captdam/DD-40/design/design spec.md

# ROV Design Spec

## Features
- Control by cable
- Camara FPV

## Physical params
- Displacement:
- Length: 40cm?
- Beam:
- Height:
- Draft:
- Propulsion:
- Speed:
- Range:
- Depth: 40m? (aiming for this goal now, final design may be far? less)

## Electrical param
- Power source: 12V Li-ion battery (or power by cable, or both?)
- Power consumption:
