captdam/DD-40/Communication/README-L1.md

# Communication protocol tech document - Physical layer

## Introduction

In this document, the method used in the physical layer of the communication system will be discussed. Firstly, the design of the circuit will be introduced, and then, the physical implementation will be discussed.

There is full-duplex UART port on the ROV's controller (ATmeage328P) and the operator-side console (STC89C52RC). By connecting the UART port of this two MCUs, the two systems would be able to exchange data between each other directly. Additionally, to give the operator a directly and clearly view of the surrounding environment of the ROV, there is a camera mounted on the ROV, which means there will be an additional wire carrying video signal.

In this document, the following terms will be used:
- Control signal: a digital signal that sends from operator-side console to the ROV. The operator will send this signal to the ROV to control the ROV, or to set up the autopilot function of the ROV.
- Data signal: a digital signal sends from ROV to the operator-side console. The ROV will gather data such as pitch angle, direction etc. and send them to the operator-side console. This signal helps the operator to understand the ROV's statue.
- Video signal: an analog video signal sends from camera of the ROV to the screen on the operator-side console.

Note: The highest frequency that a digital signal could be generated is 0.5 * BAUD (one low bit and one high bit together forms a complete square wave). In this document, the frequency will be calculated by formula "1 * BAUD " instead of "0.5 * BAUD". This will provide a safety factor of 2.

## Design scope

The ROV is a remotely controlled device, such that the deeper the ROV dives, the higher the ROV's capability will be. However, when the depth of the ROV increases, the distance between the ROV and the operator-side console will be increased as well.

Since wireless communication is impossible due to the physical limitation, a cable is applied to connect the ROV and the operator-side console. However, the wire communication still has some issue. The wire acts as an antenna so that it could gather noises. The longer the wire is, the stronger the EMI noise will be gathered from the environment. Additionally, when the transmission speed becomes faster, a stronger noise will be created.

Additionally, the physical layer should provide real-time communication and the circuit delay should be within an acceptable range.

Furthermore, to minimize the cost of the system, the circuit should be as simple as possible.

The physical layer should be able to provide a reliable, real-time (with acceptable delay), and full-duplex transmission.

## Design

### Transmission speed

The higher the transmission speed, the worse the communication quality will be. Therefore, in order to get the best communication quality, the transmission speed should be just higher than the required transmission speed of the application.

According to the testing result from software:
1. The ROV communicates with the operator-side console every 1/4 second.
2. By assuming the ROV and the operator-side console takes about 100ms to prepare data, encode and decode the package, the window for data transmission should be 150ms.
3. In each time, the ROV and the operator exchanges about 20 bytes (10 to 20) of data.
4. Each byte considers as 8 bits with an additional start bit and one additional stop bit.

(8 + 1 + 1) * 20 * (1/0.15) = 1333.33 BAUD

Ceiling to the lowest standard BAUD, the BAUD applies by this system is 2400 BAUD.

### High-voltage differential signalling (RS-485 like)

The MCU on both the operator-side and the ROV comes with a UART port. A typically TTL UART transmission is a single-wire bus to connect a master (drive the wire) with several slaves (High-Z, listen to the wire). When the data is 0, the master will drive the wire low (0V); otherwise, the master will drive the wire high (5V).

However, due to the length of the wire, strong noise could alternate the signal on the wire. When the master drives the wire high, applying a -5V noise could alternate the signal on the wire from 1 to 0; when the master drives the wire low, applying a +5V noise could alternate the signal on the wire from low to high.

TTL UART & Differential signaling

_Source: Wikipedia user upload image (by Linear77, CC BY 3.0)_

To deal with the noise issue, a differential signalling system is applied to the transmission. A differential signalling is a transmission method to send both the original signal and its negative signal. More specifically, when the transmitter sends X (1 or 0), the signal X will be placed on wire A, and the negative X will be placed on wire B. On the receiver side, by comparing the signal on wire A and B, the receiver could know the actual signal comes from the transmitter. Since the environment noise applies to both wires, the difference between the wires will not be alternated. 

For example, when the master drives the wire high, wire A will be high (5V), and wire B will be low (0V). Since the voltage on wire A is higher than the voltage on wire B, the receiver could know the signal on the wire is high:

Tx = 1;

A = 5V; B = 0V;

Rx = (A-B>0) ? 1 : 0 = 1

If applying a XV (X = negative infinity to positive infinity) noise:

Tx = 1;

A' = 5V + X; B' = 0V + X;

A' - B' = (5V + X) - (0V + X) = 5V - 0V = A - B;

By using the differential signalling method, the noise is filtered.

Since the transmission cable and 12V power supply is built in a multi-core cable, the transmission signal could be amplified to 12 V instead of 5V. During this process, the transmission system could handle a stronger EMI noise.

## Circuit design

The differential signalling system circuit is consisted of 3 parts:
- Positive amplifier (Tx+): When it receives logic 1 (5V), the output will be 12V; when it receives logic 0 (0V), the output will be 0V.
- Negative amplifier (Tx-): When it receives logic 1 (5V), the output will be 0V; when it receives logic 0 (0V), the output will be 12V.
- Receiver (Rx): If Rx+ is greater than Rx-, the output will be logic 1 (5V); otherwise, the output will be logic 0 (0V).
Since the transmission system is full duplex, there is a pair of differential signalling transmitter and receiver. One of them is responsible for sending signals from the ROV to the operator-side console, another one is for sending signal from the operator-side console to the ROV.

There are two methods to design this system. One of them is using OpAmp, and the other one is using NMOS. The following circuit and simulation results from LTSpice illustrate that the cable comes with 50 ohms of resistance and 1nC capacitance between the positive-side and negative-side of the wire due to its length.

### Method 1 - OpAmp

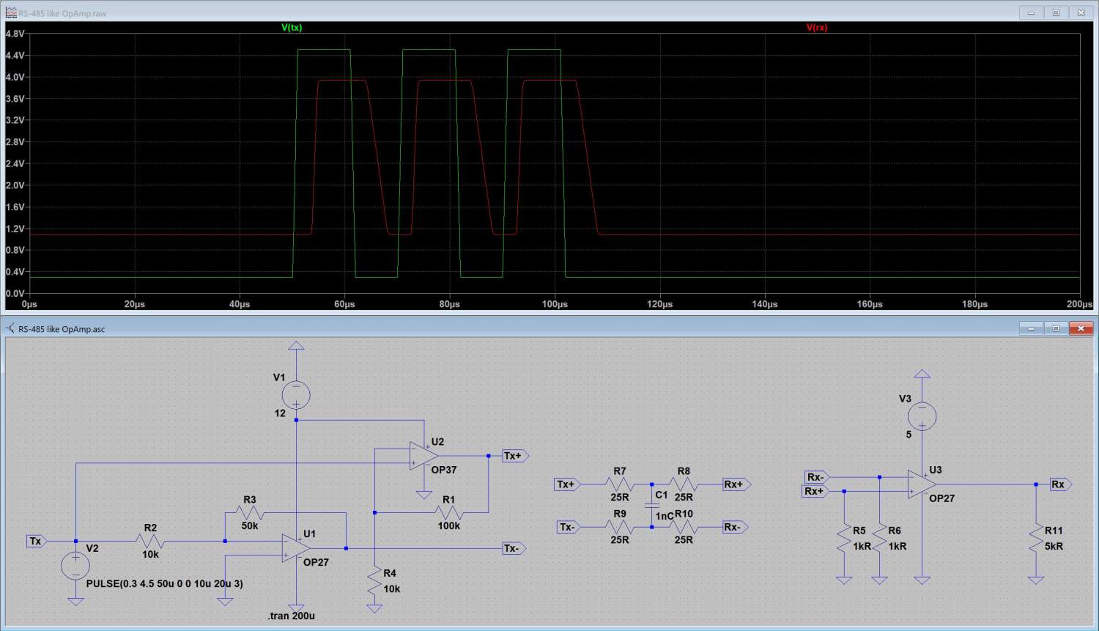
[picture p12: Communication/PhysicalLayer/RS485_like_OpAmp.jpg]
RS-485 using OpAmp


In this circuit, one OP27 is used for the negative amplifier, and one OP37 is used for the positive amplifier on the transmitter side; on the receiver side, another OP27 is used for comparing the voltage on both wires.

According to the simulation result, this solution comes with about 5-microsecond delay.

### Method 2 - NMOS

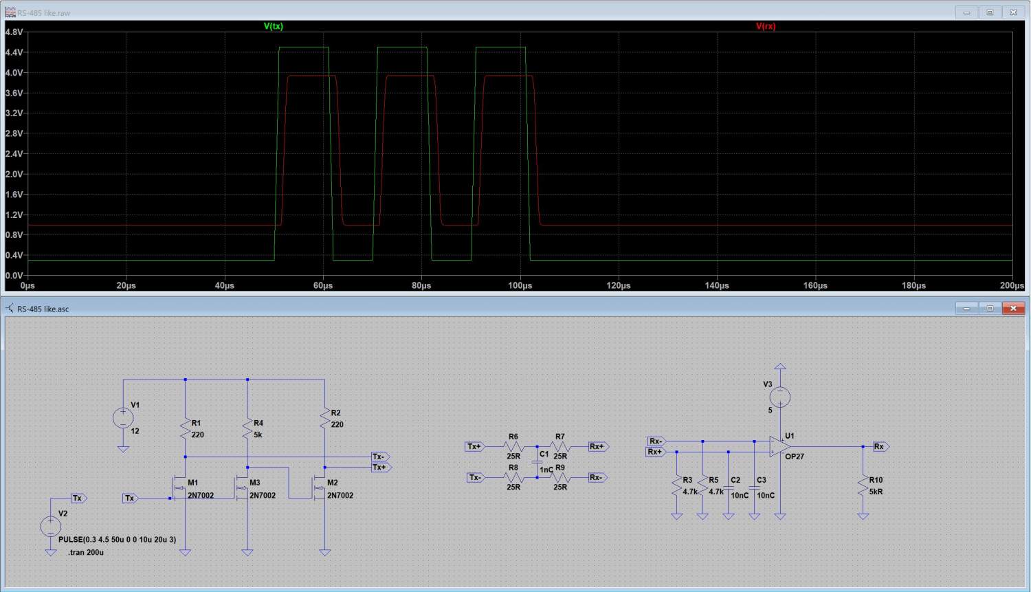
[picture p13: Communication/PhysicalLayer/RS485_like_NMOS.jpg]
RS-485 using NMOS


Like the OpAmp method, this method uses an OP27 as the comparing circuit on the receiver side. However, on the transmitter side, a 2N7002 NMOS is used for a negative amplifier; and two 2N7002 NMOS are cascade to form a positive amplifier.

According to the simulation result, the NMOS method has less delay than the OpAmp method (1.5-microsecond delay) with fewer components. However, there will always be one NMOS turns on, which means higher power consumption. By increasing the value of resistors, the power consumption could be reduced, but circuit delay may increase.

By comparing both methods, the NMOS design is chosen for the communication circuit.

## Circuit implementation

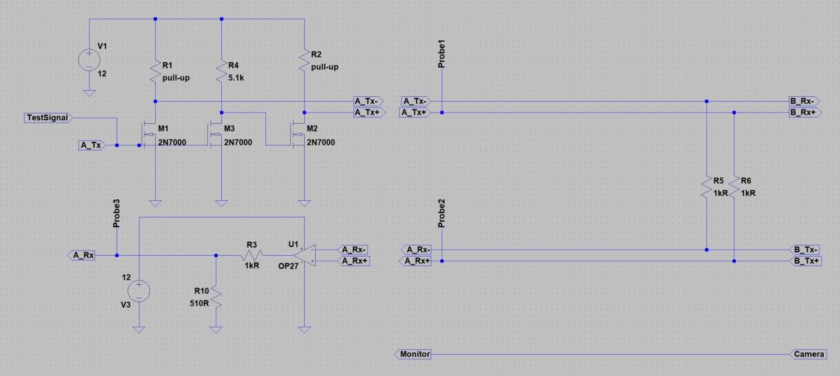
[picture p14: Communication/PhysicalLayer/scheme-test.jpg]
Test scheme


The scheme above is used to test the communication system. To finish the test, a test signal (an adjustable square wave) will be sent to the transmitter. It simulates the operator-side sending control signal to the ROV. The control wire and the data wire are shorted on the ROV side, which simulates the ROV returning the same signal to the operator side. The distance from the operator-side console to the ROV is 10 meters (for one direction).

### Digital signals (control signal and data signal)
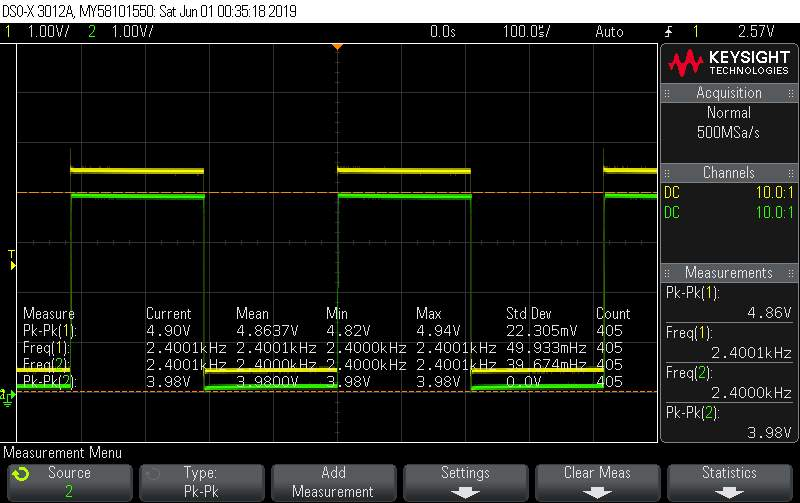
[picture p15: Communication/PhysicalLayer/scope-wave.jpg]
Test wave

 
The graph above shows the typical case. The yellow signal illustrates the input signal on the Tx, and the green signal illustrates the output signal on the Rx.

Because of the inner resistance of the transmitter of the MCU, the test signal is 2.5V+/-2V instead of 2.5V +/2.5V. The purpose of is to ensure the on/off voltage of the actual MCU is compatible with the MOSFET. For example, a TTL MCU may only provide 4.5V when it is logic high. If the Vth (threshold voltage) MOSFET is 4.8V, the 5V test signal will be able to open the MOSFET, but the actual MCU will not.

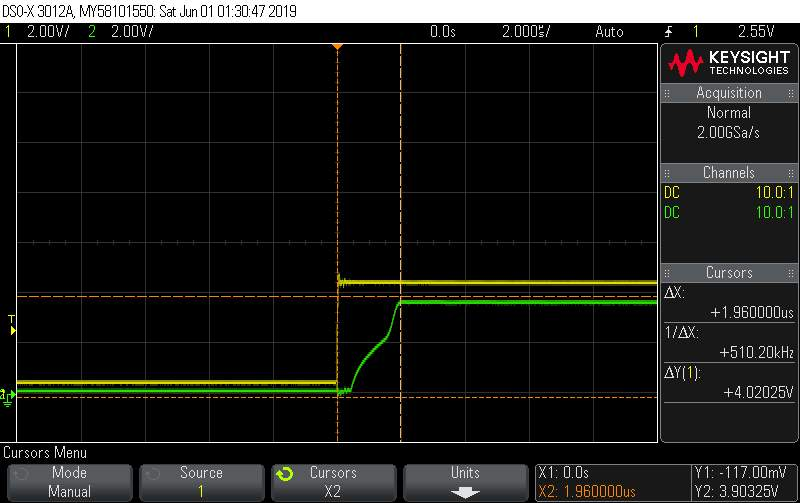
[picture p16: Communication/PhysicalLayer/scope-io.jpg]
Test wave zoom in


In the ideal case, there should be no phase difference between the input and the output signal; however, due to the natural property of the components, there will always be a delay. The communication system should provide a reasonable small delay.

Due to the supply issue, three 2N7000 is used to replace those 2N7002s on the transmitter side; an LM386 is used to replace the OP27 on the receiver side. Furthermore, the actual impedance of the transmission cord is different from the simulation. Therefore, the value of the pull-up resistors needs to be re-selected to have an acceptable compromise between the circuit delay and power consumption.

In fact, finding the suitable values of the resistors by calculation is extremely difficult. Therefore, the "buret-force" method is used to determine the value.

First, assume the pull-up resistor should be 6k ohms:

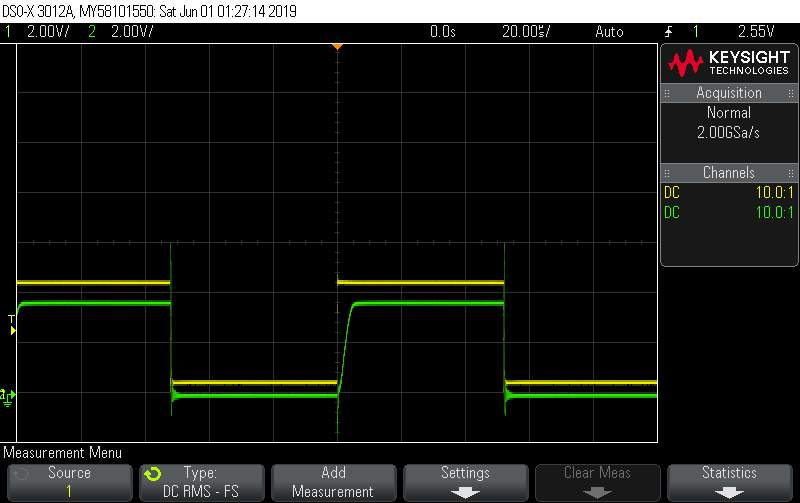
[picture p17: Communication/PhysicalLayer/scope-6k-zo.jpg]


The figure above shows the test signal (yellow) and the wave observed on probe1 (green). It is clear to say that, there is a delay when the signal changing from 0 to 1. This is because the length of wire makes itself to become a capacitor. The pull-up resistor will limit the current flow into the capacitor, which slows down the charging procedure. The result is a slow rising-edge on the wire. For the falling edge, there is no delay, because there is no resistor between the wire and the ground (resistance of MOS is neglectable).

In this case, the delay of the transmitter amplifier on the rising edge takes 5-microseconds:

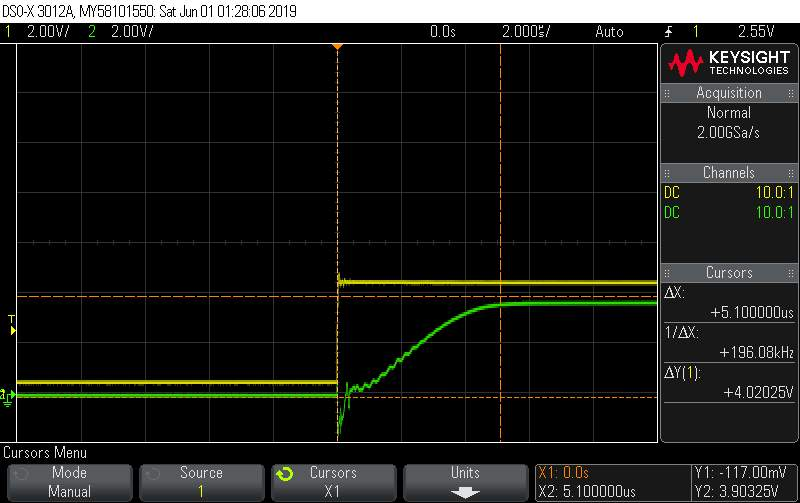
[picture p18: Communication/PhysicalLayer/scope-6k.jpg]


Decreasing the pull-up resistance could decrease the rising time. By decreasing the pull-up resistor to 2k, the delay of the transmitter amplifier on the rising edge will be decreased to 3.8-microsecond:

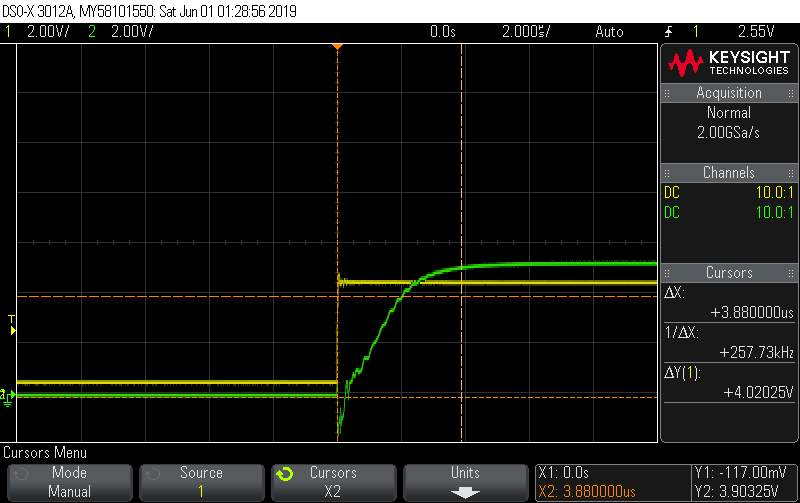
[picture p19: Communication/PhysicalLayer/scope-2k.jpg]


By decreasing the pull-up resistor to 1k, the rising time will be decreased to 3.1-microsecond, but the power consumption will be increased at the same time. Compare to the experiment with the value of 2k, the 1k resistance has a minor increasing of performance, but a significant increasing of power consumption:

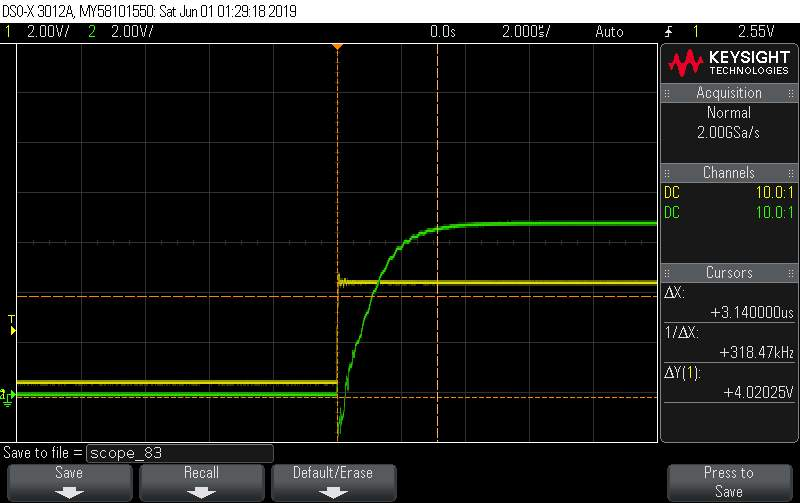
[picture p20: Communication/PhysicalLayer/scope-1k.jpg]
Test scheme - 1k pull-up


By analyzing the attempts above, the 2k resistance is chosen to apply to the circuit. The following graph shows the delay between the Tx (test signal) and Rx (probe3). The delay between the Tx and Rx is smaller than the delay between the Tx and the wire because of the gain of the OpAmp:

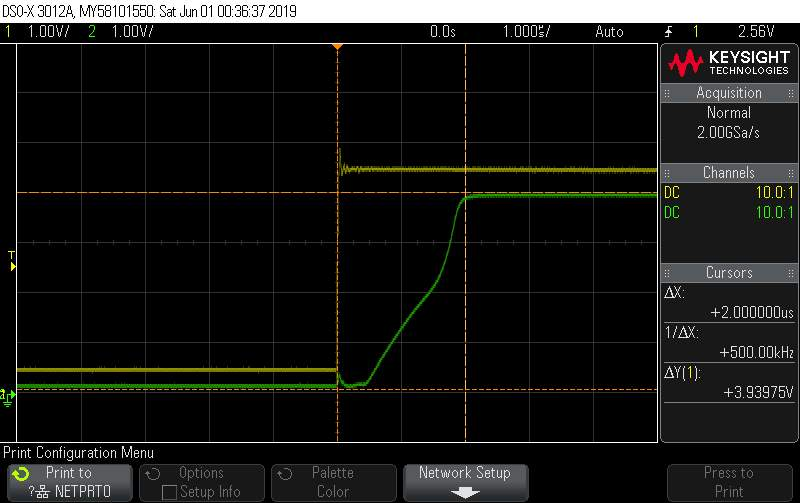
[picture p21: Communication/PhysicalLayer/scope-delay.jpg]


This circuit provides a delay (the rising time and the falling time) less than 5us with an average power consumption of 120mA, which is an acceptable compromise. The final scheme is shown below:

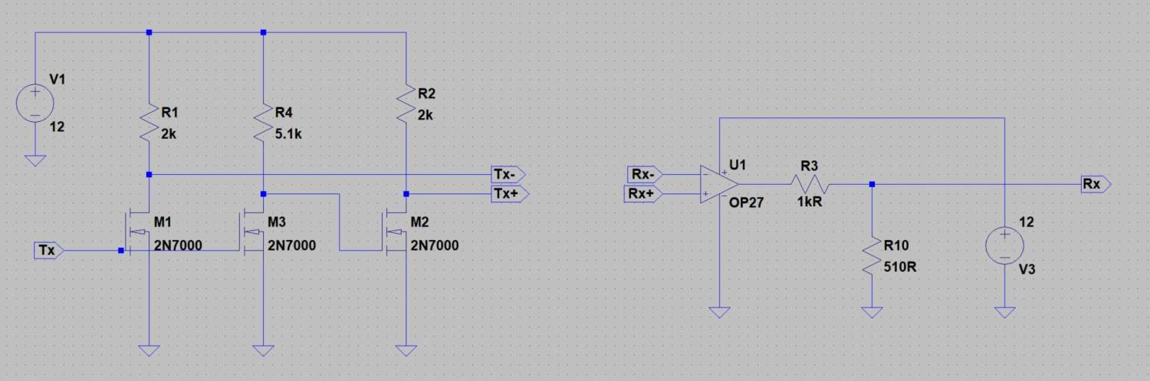
[picture p22: Communication/PhysicalLayer/scheme-final.jpg]
Final scheme


The delay is 5-microseconds, it may seem to be too long; however, the communication speed is 2400 BAUD. Assuming the data/command wires carry 2400Hz square wave, the period of the square wave is 417 microseconds, which is about 80 times of the delay.

### Video signal

The above experiments illustrate that the communication system can handle digital communication. The following experiments will determine whether the system could handle digital communication plus analog video communication together.

On one hand, although the video signal is an analog signal, it still generates EMI on the data wire and control wire. Through the benefit from the differential signalling, the EMI is neglectable. On the other hand, the data signal and control signal will generate EMI on the video. Because the video signal is not differential signalling, the effect will be significant.

It is clear to say that the quality of the video will be affected significantly by the control signal and the data signal. However, even the video will be affected, users should be able to watch the video with minor image defect. In fact, when the ROV is working underwater, the surrounding will be very dark, hence the user may not be able to notice the effect on the video signal due to EMI. Furthermore, the camera mounted on the ROV is designed for observation, not moving shooting, which means the image quality is not the primary consideration. As a result, the video image defect is neglectable.

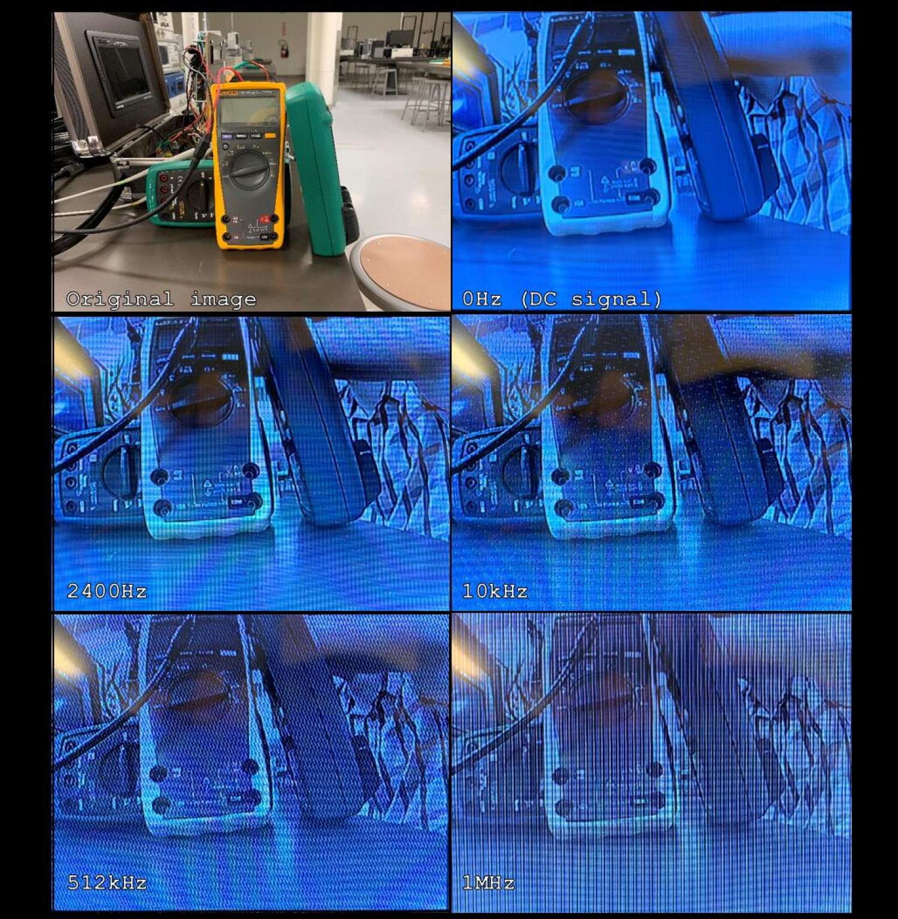
[picture p23: Communication/PhysicalLayer/video.jpg]
Video signal test


The pictures above are the experimental result. The top-left picture shows the test object.

The top-right picture shows the image coming from the camera via the 10-meter-long communication cord when there is no control signal or data signal (by powering the control wire and data wire with DC). The image loses some color accuracy due to noise and wire impedance.

The software will be exchanging data at 2400 BAUD. To simulate this kind of situation, the control wire and data wire were powered by 12V 2400Hz square wave. As the picture above, some dot could be observed on the image. This is because the switching of the data signal and control signal generates EMI on the video signal. However, the users are still able to see the video with such kind of image defect.

Although the software will not use high-frequency data exchange rate, it is good to test the system in extreme cases. If the data exchanging rate keep increasing to reach 10k BAUD (simulated by using 12V 10kHz square wave), there will be a significant defect on the image as the picture above. When the data rate reaches 1M BAUD, the video signal will be affected significantly.

In conclusion, this system is capable with the design specification.

## Cable implementation
The first concern of finding the cable for the ROV is that: the cable, particularly the connector, should be waterproof, even under certain pressure.

The second concern is that, in some cases, the ROV may be malfunction. At that time, the ROV will lose its propulsion; hence, the operator will need to use the cable to pull the ROV back. In extreme cases, the ROV may be trapped by something like seaweeds. Therefore, the cable must be able to handle a certain force.

Furthermore, because the cable carries the power of the ROV and the data/control/video signal, the cable needs to be multi-core with at least 2 power grids and at least 5 (2 for the differential-signalling control signal, 2 for the data signal, 1 for the video signal) shielded signal wires. Furthermore, due to the differential signalling, it is better to have the control signal and the data signal go through twisted pairs with different twist length.

To satisfy the requirements above, IP68 rated waterproof aviation plug is applied for the communication. As the picture below shows, the aviation plug used in this system has 7 pins, and each of them can handle up to 15A of current.

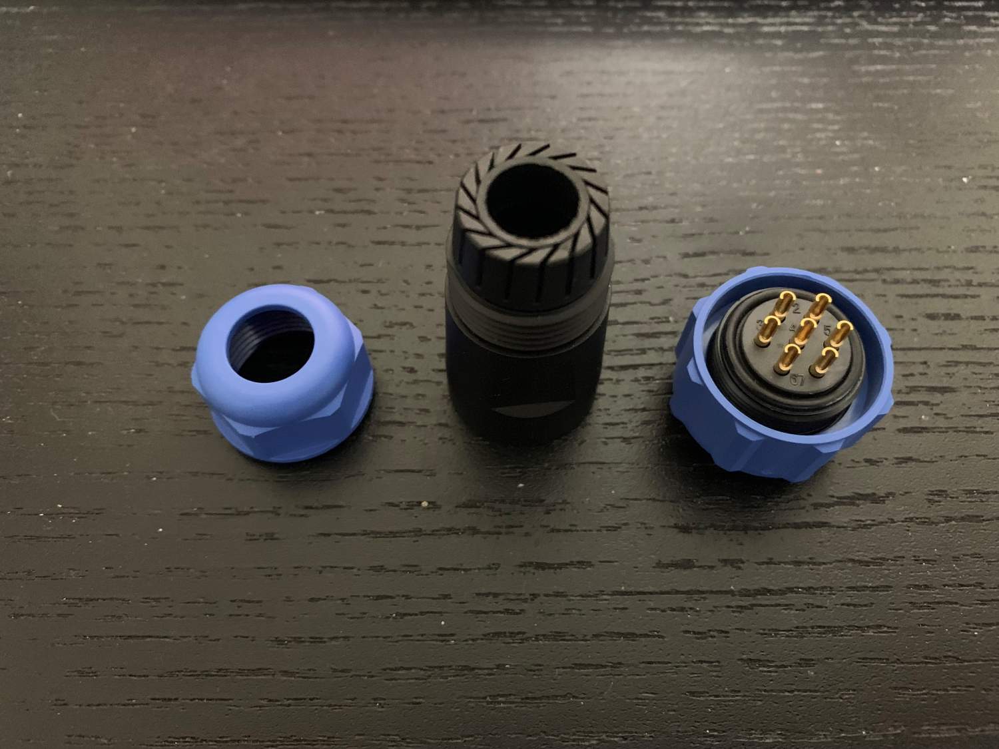
[picture p24: Communication/PhysicalLayer/connector.jpg]
Aviation connector


The cable used in this system was originally designed for elevators, which was used where required high tensile force. Like the picture below, it shows that the cable has 3 components. The first component is a pair of high strength steel cable, which is used to handle the tensile force. The second component is a pair of 1-square-millimeter power wire, which is designed for power supply. The third component is four pairs of double-shields-twisted wire with different twist length, which is used to carry signals.
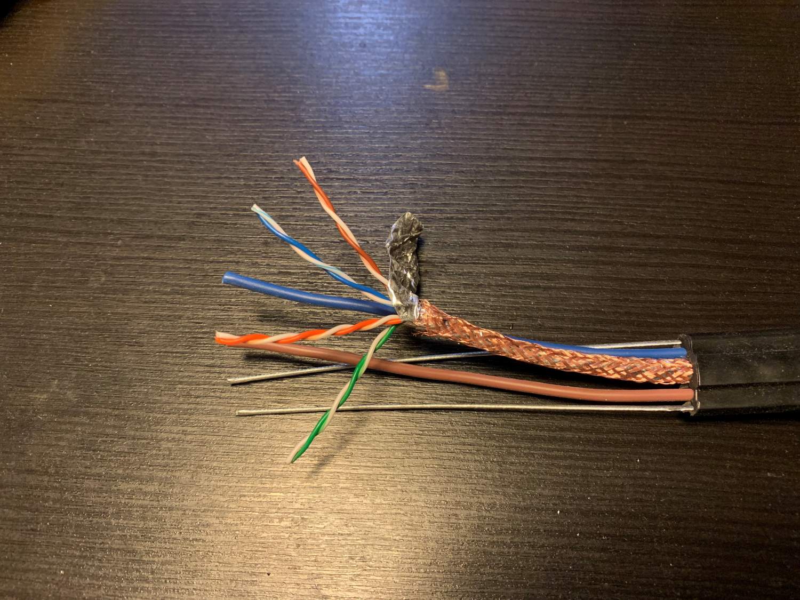
[picture p25: Communication/PhysicalLayer/cable-1.jpg]
Cable


This system requires a pair of power cable, two pairs of twisted wire for data and control signals, and one wire for the video signal. The following table shows the connection between wires and the plug. Notice that, the orange pair and the brown pair has the longest and shortest twist length. By using them for control signal and data signal respectively, it could provide the lowest EMI between them.

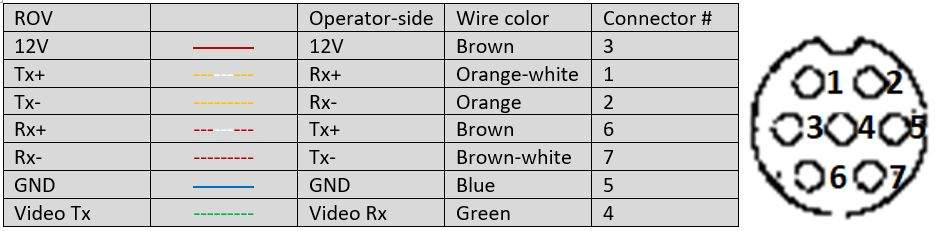
[picture p26: Communication/PhysicalLayer/connection.jpg]
Connection


The challenge here is to implement the cable system. Especially when the aviation accepts round cable, but the elevator cable is flat.

To deal with this issue, the following method is applied:

1 - Removing the outer rubber of the cable. Then, wrapping the wires with electrical tape to form a round shape.

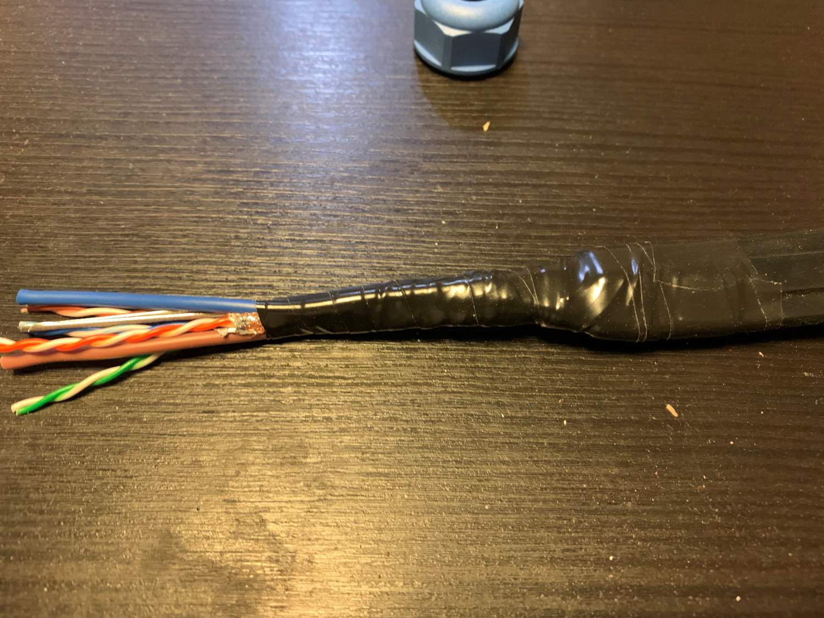
[picture p27: Communication/PhysicalLayer/cable-2.jpg]
Cable implementation


2 – Using a shrinking tube to tight the cable.

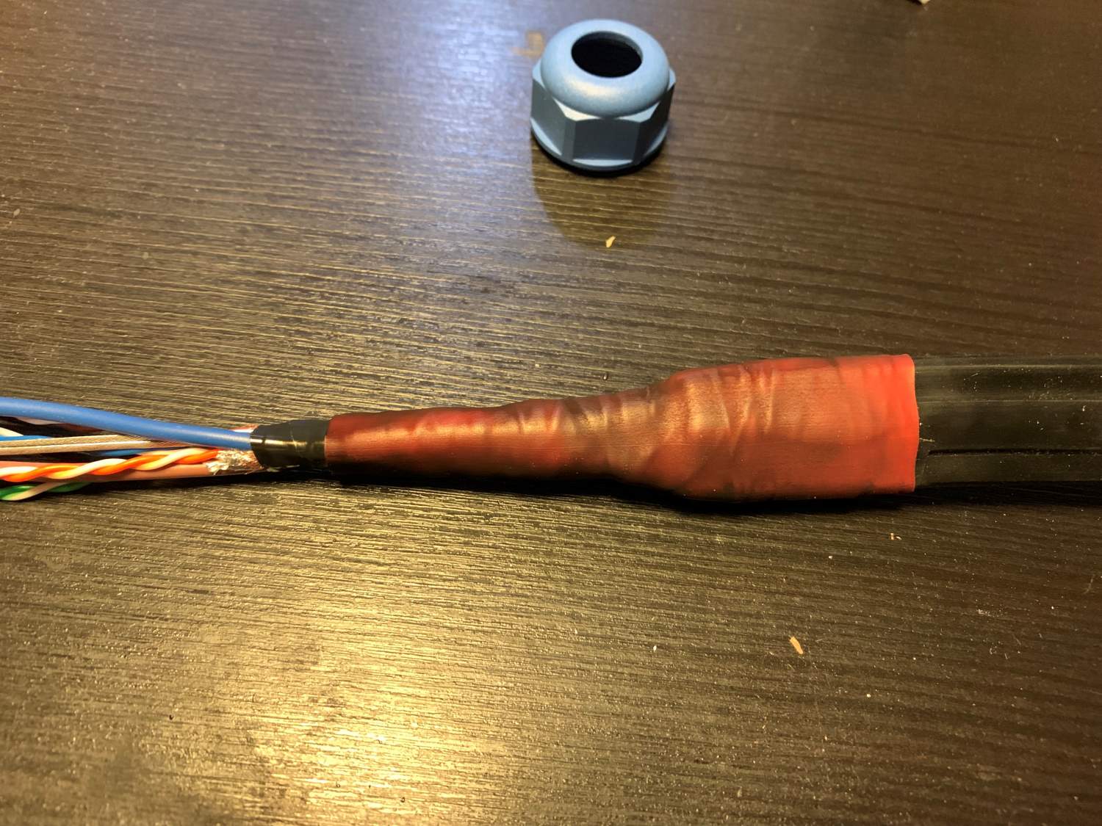
[picture p28: Communication/PhysicalLayer/cable-3.jpg]
Cable implementation


3 - Soldering the wires onto the aviation plug, according to the table.

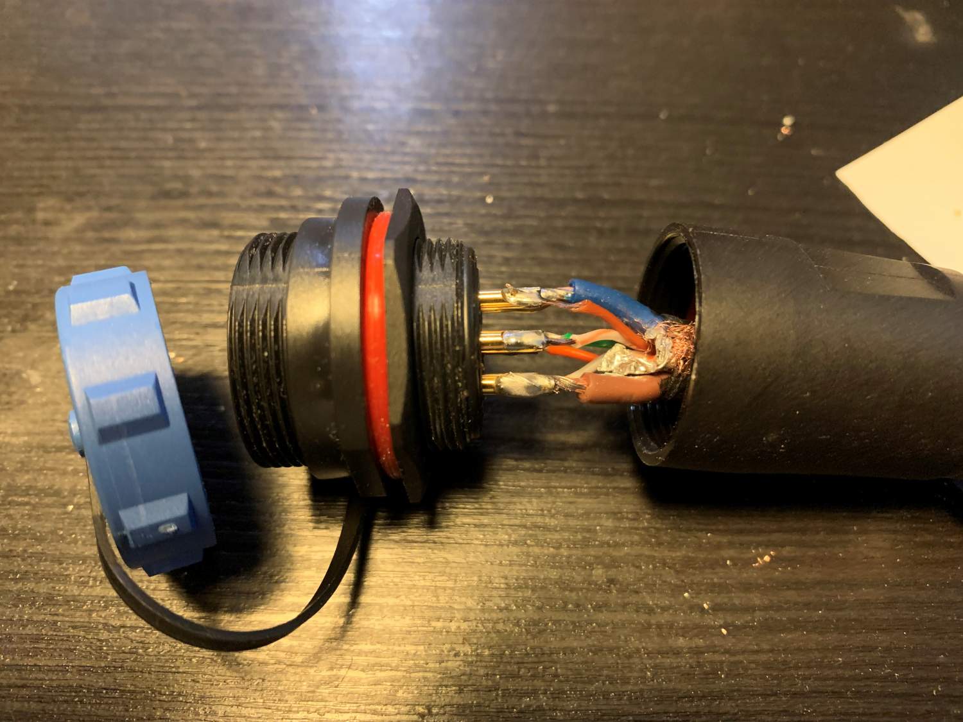
[picture p29: Communication/PhysicalLayer/cable-4.jpg]
Cable implementation


4 - Securing the aviation plug. The rubber ring located in the tail of the aviation plug's body should now tightly attached to the cable's outer layer to prevent water leakage. To prevent water leakage from the end of the shirking tube, applying a piece of aluminum foil tape to seal the cable.

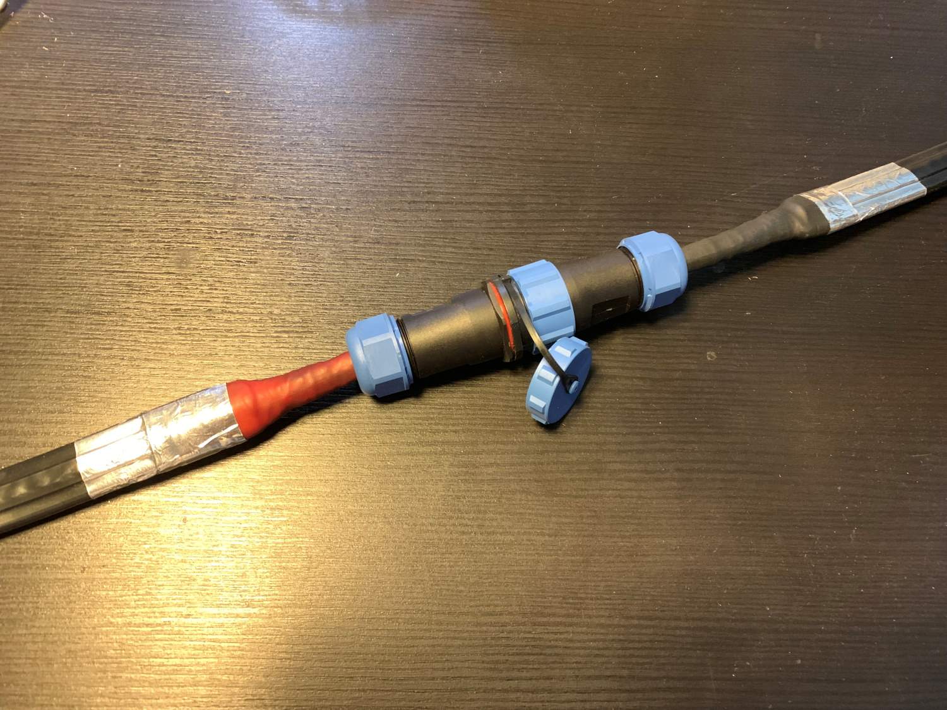
[picture p30: Communication/PhysicalLayer/cable-5.jpg]
Cable implementation


5 - For a better waterproofing performance, filling the aviation plug with silicon glue. After doing this, it is impossible to open the plug to modify the connection without breaking it. However, it seems like the wire connection in the plug will never be modified in the future.
