captdam/DD-40/design/system block.jpg

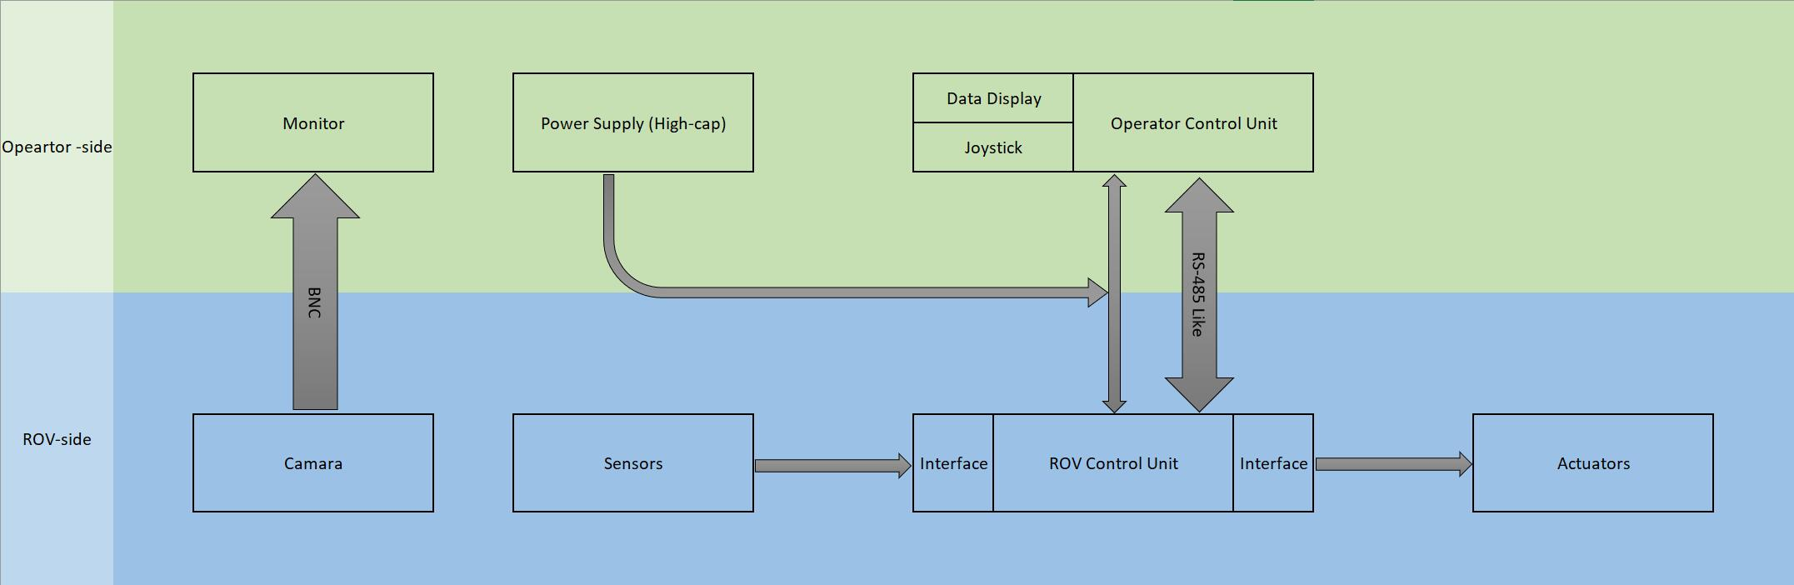
design/system block.jpg
