captdam/DD-40/ROV/doc/calib-after.jpg

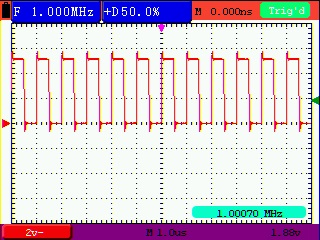
ROV/doc/calib-after.jpg
