captdam/DD-40/(list of files, drawings)

Other design files:
Operator/Circuit/circuit.dsn
ROV/Circuit/control-circuit.dsn
ROV/Circuit/head-hub.dsn
ROV/Circuit/tail-hub.dsn
