captdam/DD-40/(commit log)

2019-01-11 Create sensors
2019-01-22 Update sensors
2019-01-31 Create uart communication between ROv and controller
2019-01-31 Rename uart communication between ROv and controller to UART app protocal between ROvVand controller
2019-01-31 Rename UART app protocal between ROvVand controller to UART app protocal between ROV and controller
2019-02-02 Communication software protocol
    [USART software protocol.csv]
2019-02-02 Update protocol
    [USART software protocol.csv]
2019-02-02 Rename ROV/communication/USART software protocol.csv to Communication/USART software protocol.csv
    [USART software protocol.csv]
2019-02-03 Update communication protocol
    [USART software protocol.csv]
2019-02-03 Add ROV pin plan
    [ROV pin plan.csv]
2019-02-03 Update pin plan
    [ROV pin plan.csv]
2019-02-04 Finalize pin plan
    [ROV pin plan.csv]
2019-02-04 Finalize communication protocol
    [USART software protocol.csv]
2019-02-05 Create BOM
2019-02-12 Make lookup table for bat voltage ADC
    Battery voltage ADC BinToBCD lookup table
2019-02-23 Modify XRAM structure
    原来STC89C52不属于STC89C52大容量单片机，是STC89C52小容量单片机（你叫个8051大容量小容量也好呀）
2019-02-23 Fix
    Adding boundary for UART buffer.
    Fix math mistake.
2019-02-23 Operator program finished and tested
    Tested by using make-up data on the UART port. Test passed!
2019-02-26 Update BOM
2019-03-01 Astable Multivibrator circuit
2019-03-01 Create Operator Flow Chart.jpg
2019-03-08 Fix flow chart error
2019-06-09 Update communication framework
2019-06-12 Adding schem for ROV control circuit
    [control-circuit.dsn]
2019-06-12 Remove circuit schem
    Those circuit has been implement into other circuits
2019-06-12 Adding ROV head hub circuit schem
    [astable multivibrator.dsn, head-hub.dsn]
2019-06-12 Create myMCU.TCLib
    CAD tool custom lib
2019-06-17 Create Fuse from factory
2019-06-17 Update Fuse from factory
2019-07-05 Create rov circuit note
2019-07-05 Update rov circuit note
2019-07-31 Upload operator-side console schmetic
    [circuit.dsn]
2019-07-31 Update schmetic
    [circuit.dsn]
2019-07-31 Upload schmetic and photo
    [tail-hub.dsn]
2019-08-02 Create Readme main control board
2019-08-02 Update Readme main control board
2019-08-02 Update and rename ROV/Readme main control board to Operator/README-MECH.md
2019-08-02 Rename folder
    [circuit.dsn]
